sigroot/MCDProject/readme.md

This project is to design a MC68K based microcomputer on a single board.

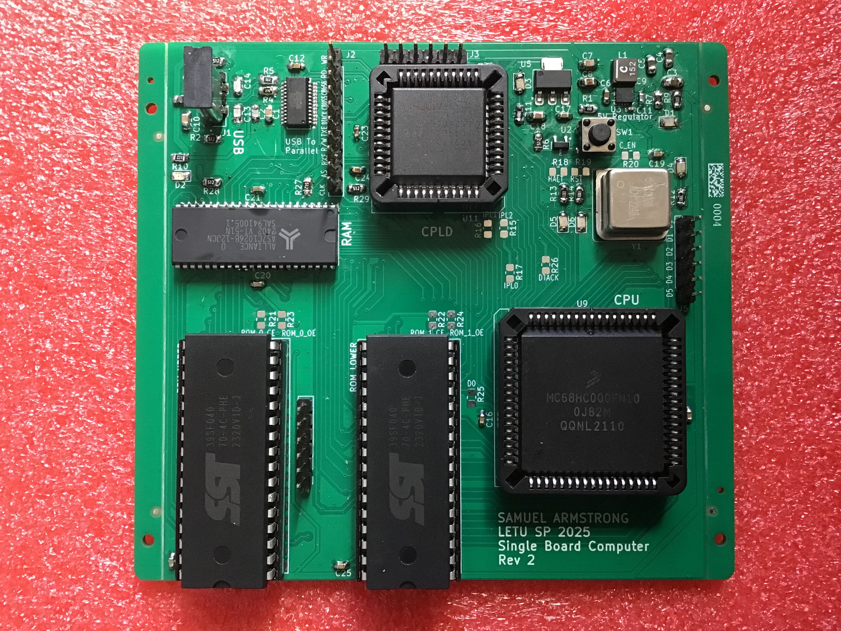
[picture p1: Images/CompletedBoard.jpg]
Board Photo
