sigroot/MCDProject/Metadata.ods

Sheet: TimeManagement
Date | Activity | Time Slot | Total Minutes | Total Hours |  |  |  | Lab Day
1-13 | Reading Docs | 3:33 – 5:26 | 113 | 1.88333333333333 |  |  |  | 02/19/25 | Listened to Dr. Kim Lecture, left early
1-14 | Reading Parts | 6:30 - 8:30 | 120 | 2 |  |  |  | 02/21/25 | Looked into interrupt
1-15 | Organizing Resouces | 2:36 – 2:44 | 8 | 0.133333333333333 |  |  |  |  |  | 1 | 2 | 3 | 4 | 5 | 6 | 7 | 8 | 8 | 9 | 10 | 11 | 12 | 13 | 14 | 15
1-15 | Reading Parts | 2:45 – 3:05 | 20 | 0.333333333333333 |  |  |  |  |  | 23.0833333333333 | 18.0666666666667 | 14.2666666666667 | 16.15 | 19.3666666666667 | 4.58333333333333 | 7.08333333333333 | 19.7083333333333 | 19.7083333333333 | 12.6666666666667 | 9.5 | 12 | 13.7666666666667 | 9.25
1-15 | Reading Parts | 7:23 – 8:52 | 89 | 1.48333333333333 |  |  |  |  |  |  |  |  |  |  |  |  |  |  |  |  |  |  |  |  | 14.2285714285714 | 213.428571428571
1-16 | Diagramming, Reading Textbook, Reading Parts, Research | 2:36 - 3:43 | 67 | 1.11666666666667
1-16 | Research, Part Selection, Reading | 4:05 - 5:00 | 55 | 0.916666666666667
1-16 | Reading Textbok, Reading Parts, PLCC Research | 5:30 - 6:59 | 89 | 1.48333333333333
1-18 | Bibliography | 9:45 - 9:58 | 13 | 0.216666666666667
1-18 | Spread-sheeting, Part search | 12:11 – 2:44 | 153 | 2.55
1-20 | Part Search, Spreadsheeting, Reading | 1:13 –5:05 | 232 | 3.86666666666667
1-20 | Part Search | 6:20 – 7:20 | 60 | 1
1-21 | Part Search, Schematic | 9:07 – 11:40 | 153 | 2.55
1-21 | Price Calculation, Schematics | 6:10 – 8:13 | 123 | 2.05 | Week 1
1-21 | Block Diagram | 8:14 – 9:45 | 90 | 1.5 | 23.0833333333333
1-22 | Weekly Report | 2:12 – 2:40 | 38* | 0
1-22 | Weekly Report | 3:05 – 4:15 | 70* | 0
1-22 | Part Search, Phil’s Lab tutorials | 5:45 – 8:23 | 158 | 2.63333333333333
1-23 | Found Buck-Boost Regulator | 8:03 – 9:03 | 60 | 1
1-23 | Part Search, Schematic Rewriting | 10:31 – 11:24 | 53 | 0.883333333333333
1-23 | Schematic Writing | 3:33 – 5:44 | 131 | 2.18333333333333
1-25 | USB-C Connection Reading | 10:31 – 12:15 | 104 | 1.73333333333333
1-25 | USB Wiring | 2:55 – 4:06 | 71 | 1.18333333333333
1-25 – 1-26 | Schematic Writing | 8:20 – 12:59 | 279 | 4.65
1-27 | Researching USB to Parallel, Schematic-ing | Many | 120 | 2 | Week 2
1-28 | Schematic Editing | 7:00 – 7:30 | 30 | 0.5 | 18.0666666666667
1-28 | Program Flowchart | 9:30 – 10:48 | 78 | 1.3
1-29 | Complete Schematic | 2:56 -… 3:45 | 49 | 0.816666666666667 |  | Time spent in January
1-30 | Collecting Footprints | 5:06-6:16 | 80 | 1.33333333333333 |  | 43.3
2-2 | Fixing Footprints | 4:30 – 5:06 | 36 | 0.6
2-2 | Finishing Schematic Again | 5:27 - 8:38 | 191 | 3.18333333333333
2-3 | Starting PCB, fixing footprints, setting design rules | 7:45-8:00, 11:45-12:05 | 35 | 0.583333333333333
2-3 | Working on PCB/Footprints | 3:29-5:33 | 124 | 2.06666666666667
2-4 | PCB Editing | 11:00-12:50 | 110 | 1.83333333333333
2-4 | PCB Editing, Adding sockets to BOM | 6:00 – 7:45 | 105 | 1.75
2-5 | Parts Ordering, Adding sockets to BOM | 7:50 – 8:20 | 30 | 0.5
2-5 | Parts Ordering | 10:40 – 11:33 | 53 | 0.883333333333333 | Week 3
2-5 | Parts Verifying, PCB work | 11:35 – 12:18 | 43 | 0.716666666666667 | 14.2666666666667
2-5 | Checking for parts on JLCPCB | 2:35 – 2:55 | 20 | 0.333333333333333
2-5 | Editing PCB | 6:45 – 9:20 | 145 | 2.41666666666667
2-6 | Editing PCB | 11:00 – 1:06 | 126 | 2.1
2-6 | Editing PCB | 4:04 – 5:45 | 101 | 1.68333333333333
2-8 | Editing PCB | 8:17 – 10:18 | 121 | 2.01666666666667
2-9 | Editing PCB | 12:15 – 5:51 | 336 | 5.6
2-10 | Conducting Schematic Fixes | 4:05 – 5:05 | 60 | 1 | Week 4
2-11 | Conducting Schematic Fixes | 12:00 – 1:00 | 60 | 1 | 16.15
2-12 | Finalizing Schematic Fixes | 3:30 - 3:45 | 15 | 0.25
2-12 | Fixing Fixes | 6:20 – 6:55 | 35 | 0.583333333333333
2-12, 2-13 | Editing PCB | 7:01 – 2:13 | 432 | 7.2
2-13 | Editing PCB | 12:25-1:15 | 50 | 0.833333333333333
2-14 | Editing PCB, Ordering Parts | 10:45 – 12:20 | 95 | 1.58333333333333
2-15 | Editing PCB | 2:30 – 5:30 | 180 | 3
2-16 | Finalizing PCB | 1:00 – 2:22 | 82 | 1.36666666666667
2-16 | PCB Editing | 2:39 – 3:03 | 24 | 0.4
2-16 | PCB Editing | 3:30 – 5:44 | 134 | 2.23333333333333
2-16 | PCB Ordering | 6:12 – 7:37 | 85 | 1.41666666666667 | Week 5 | 90.4333333333333
2-18 | Starting VHDL Project | 12:48 – 1:18 | 30 | 0.5 | 19.3666666666667
2-20 | Writing VHDL | 2:45 – 5:00 | 145 | 2.41666666666667
2-25 | Researching Interrupt programming | 12:55 – 1:22 | 27 | 0.45 | Week 6
2-25 | Writing VHDL | 6:07 – 7:50 | 103 | 1.71666666666667 | 4.58333333333333
2-27 | Starting Soldering | 3:00 – 6:00 | 180 | 3 |  | Time spent in February
2-28 | Completing Soldering (minus switch) | 2:00 – 5:00 | 180 | 3 |  | 58.2166666666667
3-1 | Added switch and socketed chips to board | 1:15 – 1:50 | 35 | 0.583333333333333 | Week 7
3-3 | Correcting VHDL | 11:20 – 11:50 | 30 | 0.5 | 7.08333333333333
3-5 | Finishing? VHDL, Installing FTDI Chip Drivers | 2:00 – 3:15 | 75 | 1.25
3-6 | Attempting to connect via FTDI drivers | 10:55 – 12:35 | 100 | 1.66666666666667
3-6 | Trying to figure out why the board cannot be seen (Found 3V3OUT only produces 1.4V) | 2:50 – 4:40 | 110 | 1.83333333333333
3-10 | Failed to desolder the FTDI chip, destroyed pads, need to resolder | 1:10 – 7:50 | 400 | 6.66666666666667 |  | 10.1666666666667
3-11 | Successfully desoldered USB connector | 1:05 – 1:40 | 35 | 0.583333333333333
3-11 | Desoldered old board, soldered new board | 2:00 – 11:00 | 540 | 9 | Week 7.5
3-12 | Attempted to see board from PC | 5:30 – 7:10 | 100 | 1.66666666666667 | 22.6666666666667
3-13 | Managed to see FTDI (Resistor on D+ was bad, Reset was being pulled to ground by unprogrammed CPLD) | 3:05 – 3:28 | 23 | 0.383333333333333
3-13 | Testing board, learning makefiles | 3:30 – 4:05 | 35 | 0.583333333333333
3-14 | Learnking makefiles | 12:00 – 12:27 | 27 | 0.45
3-14 | Writing VHDL to CPLD | 1:30 – 1:45 | 75 | 1.25
3-14 | Attempting to program ROM (Can’t detect programmer on linux) | 3:00 – 4:25 | 85 | 1.41666666666667
3-15 | Getting Pi4 ready | 11:00 – 12:00 | 60 | 1
3-15 | Making ROM Programmer | 2:00 – 6:30 | 270 | 4.5
3-17 | Connecting to programmer | 4:00 – 5:20 | 80 | 1.33333333333333
3-18 | Attempting to program ROM (Could program, wrong result) | 12:00 – 1:20 | 80 | 1.33333333333333
3-18 | Troubleshooting Board | 4:30 – 7:00 | 150 | 2.5
3-18 | Realizing error in VHDL | 8:45 – 9:00 | 15 | 0.25 | Week 8 | Weeks 7.5 + 8
3-19 | Successfully ran code | 10:25 – 12:10 | 105 | 1.75 | 16.75 | 39.4166666666667
3-19 | Attempting to receive “Hello, World!” (Garbled) | 7:05 – 9:00 | 115 | 1.91666666666667
3-20 | Got “Hello, World!”, working on interrupts | 2:30 – 5:45 | 195 | 3.25
3-22 | Attempted to probe for RAM issues | 4:00 – 4:55 | 55 | 0.916666666666667
3-22 | Confirmed RAM is functional, Wrote program, Determined possible VHDL write communication issue. | 6:10 – 9:00 | 170 | 2.83333333333333
3-24 | Attempting echo sent text | 2:10 – 4:00 | 110 | 1.83333333333333
3-26 | Probing communication | 1:30 – 2:30 | 60 | 1 | Week 9
3-26 | Debugging communication code | 7:30 – 8:25 | 55 | 0.916666666666667 | 12.6666666666667
3-28 | Debugging with Lucas (oscilloscope) | 10:30 – 12:40 | 130 | 2.16666666666667
3-29 | Debugging communication code | 4:15 – 5:45 | 90 | 1.5
3-29 | Checking results of debugging (noticed read bytes match opcode values) | 6:30 – 6:45 | 15 | 0.25 |  | Time spent in March
3-30 | Fixing UTP reads | 12:45 – 350 | 185 | 3.08333333333333 | Week 10 | 60.1666666666667
4-1, 2 | Making Linker Script | 11:30 – 2:00 | 150 | 2.5 | 9.5
4-2 | Attempting to use C code | 6:00 – 7:00 | 60 | 1
4-3 | Realized trying to write to linker symbols causes crash, writes are done manually now | 2:30 – 6:50 | 260 | 4.33333333333333
4-6 | Working on Code | 2:00 – 4:00 | 120 | 2
4-6 | Got linker to work with includes | 5:15 – 6:15 | 60 | 1
4-7 | Testing the pins for errors | 11:45-12:15 | 30 | 0.5
4-8 | Reprogramming main | 10:45 – 1:00 | 145 | 2.41666666666667 | Week 11
4-9 | Working on Monitor | 11:45 – 12-30 | 45 | 0.75 | 12
4-10 | Got monitor main menu working | 2:30 – 5:24 | 176 | 2.93333333333333
4-11 | Got parsing | 10:30 – 12:45 | 135 | 2.25
4-12 | Working on monitor | 3:15 – 4:15 | 60 | 1
4-13 | Working on monitor | 2:00 – 4:15 | 135 | 2.25 | Week 12
4-13 | Finish V1 on monitor | 6:30 – 11:50 | 320 | 5.33333333333333 | 13.7666666666667
4-14 | Testing monitor. | 8:50 – 9:30 | 40 | 0.666666666666667
4-14 | Made tweaks to monitor. Works properly. Worked on S-Record | 10:35 – 12:35 | 120 | 2 |  |  | 85.7166666666667
4-20 | Commenting Monitor | 1:35 – 2:10 | 35 | 0.583333333333333 |  | Time spent in April
4-20,4-21 | Writing S-Record Program (Fireplace) | 8:00 – 2:00 | 360 | 6 | Week13 | 37.5166666666667
 |  |  | 11952 | 199.2 | 9.25

Sheet: Sources
Links | Notes
https://www.youtube.com/watch?v=0LSG5uIdqJc
resources.altium.com
https://www.microwaves101.com/encyclopedias/even-and-odd-mode-impedances
https://blog.clevercompliance.io/electrical-product-compliance/what-is-emc-testing/
https://www.pcbasic.com/blog/power_supply_pcb.html
https://ww1.microchip.com/downloads/aemDocuments/documents/VOP/ApplicationNotes/ApplicationNotes/Signal+Types+and+Terminations.pdf
https://www.reddit.com/r/AskElectronics/comments/15q1bvo/how_well_regulated_is_usb_will_the_supply_voltage/
https://www.ti.com/lit/an/slyt118/slyt118.pdf
https://stackoverflow.com/questions/12678698/emulating-uart-over-usb
https://www.circuitbread.com/tutorials/communicating-with-a-pc-using-uart---part-11-microcontroller-basics-pic10f200
https://www.nextpcb.com/blog/spi-i2c-uart
https://electronics.stackexchange.com/questions/110478/difference-between-uart-and-rs-232
https://madpcb.com/glossary/
https://resources.altium.com/p/copper-pour-and-stitching-do-you-need-them-pcb-layout
https://www.altium.com/documentation/altium-designer/via-stitching-via-shielding-pcb
https://www.analog.com/en/resources/technical-articles/successful-pcb-grounding-with-mixedsignal-chips--follow-the-path-of-least-impedance.htmlhttps://www.eur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
https://ecsxtal.com/store/pdf/output-signal-types.pdf
https://superuser.com/questions/317217/whats-the-maximum-typical-speed-possible-with-a-usb2-0-drive
https://www.raypcb.com/soic-vs-ssop/
https://reversepcb.com/the-basics-of-quad-flat-no-leads-qfn-packaging/
https://www.howtogeek.com/53587/usb-explained-all-the-different-types-and-what-theyre-used-for/
https://resources.altium.com/p/isolated-vs-non-isolated-power-supplies-right-choice-without-fail
https://www.ablic.com/en/semicon/products/power-management-ic/switching-regulator/intro-2/
https://digilent.com/reference/_media/jtag-usb_full_speed/jtag-usb_fs_rm.pdf
https://electronics.stackexchange.com/questions/566073/why-usb-c-has-4-vbus-and-how-does-it-affect-my-design
https://electronics.stackexchange.com/questions/4515/how-to-connect-usb-connector-shield
https://www.allaboutcircuits.com/technical-articles/introduction-to-usb-type-c-which-pins-power-delivery-data-transfer/
https://www.analogictips.com/what-is-pssr-and-why-is-it-important-in-op-amps-and-ldos-faq/
https://store.curiousinventor.com/guides/Surface_Mount_Soldering/QFN
https://www.youtube.com/@PhilsLab/search?query=USB-C
https://electronics.stackexchange.com/questions/327791/using-usb-c-as-a-power-source
https://www.ti.com/lit/an/snva559c/snva559c.pdf
https://forum.kicad.info/t/how-to-do-dip-sockets-and-the-dip-parts/51956/4
https://github.com/KiCad | For footprints
https://www.baldengineer.com/kicad-bus-labels-and-global-labels.html
https://www.ti.com/lit/sg/sdyu001ab/sdyu001ab.pdf?ts=1737822780380 | VIH is Voltage of an input for high value. MCU is 2V min
https://www.digikey.com/en/maker/projects/how-to-route-differential-pairs-in-kicad-for-usb/45b99011f5d34879ae1831dce1f13e93
https://www.ti.com/lit/wp/slyy109b/slyy109b.pdf?ts=1682067298687
https://developerhelp.microchip.com/xwiki/bin/view/applications/usb/typec-features/cc-vconn-signals/
https://ww1.microchip.com/downloads/en/AppNotes/00001953A.pdf | USB-C Datasheet
https://makbit.com/forum/viewtopic.php?t=21
https://www.edn.com/add-a-manual-reset-to-a-standard-three-pin-reset-supervisor/
https://hackaday.com/2014/03/05/hackaday-68k-blinking-a-led/ | Descriptions of extra pins and how to ignore them
https://electronics.stackexchange.com/questions/389972/usb-shield-to-ground-or-not-to-ground
https://docs.kicad.org/master/en/eeschema/eeschema_schematic_creation_and_editing.html
https://www.ecstaticlyrics.com/electronics/USB/FT240X/
https://resources.altium.com/p/how-do-ferrite-beads-work-and-how-do-you-choose-right-one
https://www.pcbasic.com/blog/circuit_board_capacitor.html
https://www.macrofab.com/blog/bypass-caps-decouple-your-way-to-cleaner-power/
https://regextutorial.org/regex-for-numbers-and-ranges.php | For auto netclass assignment
http://dangerousprototypes.com/blog/2011/11/05/app-note-cpld-special-function-pins/
https://makbit.com/forum/viewtopic.php?t=21
https://forum.kicad.info/t/difference-between-f-fab-and-f-silks/16994
https://www.youtube.com/watch?v=uQkCe9-b9FI | How to use a desolder gun
https://electronics.stackexchange.com/questions/86961/how-to-assign-physical-pins-of-fpga-to-xilinx-ise-verilog-modules
https://electronics.stackexchange.com/questions/86961/how-to-assign-physical-pins-of-fpga-to-xilinx-ise-verilog-modules
https://adaptivesupport.amd.com/s/question/0D52E00006hpaGgSAI/connecting-io-pins-in-chipscope?language=en_US
https://hackaday.com/2008/12/11/how-to-programmable-logic-devices-cpld/
https://www.etechnophiles.com/raspberry-pi-4-gpio-pinout-specifications-and-schematic/ | Note: RP4 GPIO CANNOT take 5V input
https://sourceware.org/binutils/docs/ld | How to use linker scripts
https://wiki.osdev.org | How to do baremetal commands
https://softwareengineering.stackexchange.com/questions/194339/frame-pointer-explanation
https://stackoverflow.com/questions/7943628/where-will-a-constant-string-be-stored-in-memory | A comment mentioned .rodata
https://www.geeksforgeeks.org/length-of-array-in-c/
https://mcuoneclipse.com/2013/04/14/text-data-and-bss-code-and-data-size-explained/
https://hackaday.com/2018/05/02/directly-executing-chunks-of-memory-function-pointers-in-c/
https://gist.github.com/ConnerWill/d4b6c776b509add763e17f9f113fd25b

Sheet: Parts
Nickname | Part Name | Datasheet | Digikey Link | Price | Voltage Req. (V) | Current Used (mA) | Given? | Quantity | Notes | Used
MPU | MC68HC000FN10 | https://www.nxp.com/docs/en/reference-manual/MC68000UM.pdf | N/A | 0 | 5 | 30 | TRUE | 1 | 10MHz, 68-PLCC | x
MPU-Socket | 8468-11B1-RK-TP | https://www.digikey.com/en/products/detail/3m/8468-11B1-RK-TP/1026475 | https://www.digikey.com/en/products/detail/3m/8468-11B1-RK-TP/1026475 | 2.79 | N/A | N/A | FALSE | 1 | 68-pin,There are also PLCC | x
CPLD | XC9572XL-10PC44I | https://docs.amd.com/v/u/en-US/ds057 | https://www.digikey.com/en/products/detail/amd/XC9572XL-10PC44I/406978 | 0 | 3.3 | 30-60 | TRUE | 1 | Given, 10MHZ, 44-PLCC, 34 User I/O | x
CPLD Socket | 8444-11B1-RK-TP | https://www.digikey.com/en/products/detail/3m/8444-11B1-RK-TP/1026473 | https://multimedia.3m.com/mws/media/358813O/3m-chip-carrier-sockets-lp-4-row-t-h-8400-series-ts2148.pdf | 2.14 | N/A | N/A | FALSE | 1 | 44-pin, There are also PLCC | x
JTAG Header | ADT-AMP1251106S4BS165A1 | https://app.adam-tech.com/products/download/data_sheet/192971/adt-amp1251106s4bs165a1-data-sheet.pdf | https://www.digikey.com/en/products/detail/adam-tech/ADT-AMP1251106S4BS165A1/9832042 | 0.85 | N/A | N/A | FALSE | 1 | 1x6 Header 2.54 pitch | x
Oscillator | ACH-8.000MHZ-EK | https://abracon.com/Oscillators/ACH.pdf | https://www.digikey.com/en/products/detail/abracon-llc/ACH-8-000MHZ-EK/675379 | 2.66 | 5 | 30 | FALSE | 1 | 5V, slightly lower than chips’ max clock | x
0.5 MB Flash ROM | SST39SF040-70-4C-NHE | https://ww1.microchip.com/downloads/aemDocuments/documents/MPD/ProductDocuments/DataSheets/SST39SF010A-SST39SF020A-SST39SF040-Data-Sheet-DS20005022.pdf | https://www.digikey.com/en/products/detail/microchip-technology/SST39SF040-70-4C-NHE/2297834 | 2.76 | 5 | 10 | FALSE | 2 |  | x
64k x 16 bit (1MB) SRAM | AS7C1026B-12JCN | https://www.alliancememory.com/wp-content/uploads/pdf/sram/fa/as7c1026bv1.3.pdf | https://www.digikey.com/en/products/detail/alliance-memory-inc/AS7C1026B-12JCN/4234605 | 3.83 | 5 | 100 | FALSE | 1 | Low power when not read or written from | x
Button | PTS647 | https://www.ckswitches.com/media/2567/pts647.pdf | https://www.digikey.com/en/products/detail/c-k/Y97KT23B0FAFP/21395848 | 0 | N/A | N/A | TRUE | 1 | For Reset | x
USB Port | UJ20-C-V-C-3-SMT-TR | https://www.sameskydevices.com/product/resource/uj20-c-v-c-3-smt-tr.pdf | https://www.digikey.com/en/products/detail/same-sky-formerly-cui-devices/UJ20-C-V-C-3-SMT-TR/24766913 | 0.89 | N/A | N/A | FALSE | 1 | USB 2.0 | x
USB to Parallel | FT240XS-R | https://www.ftdichip.com/Support/Documents/DataSheets/ICs/DS_FT240X.pdf | https://www.digikey.com/en/products/detail/ftdi-future-technology-devices-international-ltd/FT240XS-R/3029137 | 2.38 | 5V | 8 | FALSE | 1 | 3.3V Out supply max 50mA, 12MHz clock | x
Supervisor Chip 5V | MIC2774N-46YM5-TR | https://ww1.microchip.com/downloads/en/DeviceDoc/mic2774.pdf | https://www.digikey.com/en/products/detail/microchip-technology/MIC2774L-46YM5-TR/1616833 | 0.95 | 5V | 0.0035 | FALSE | 1 | Open Drain Reset Output | x
Supervisor Chip 3.3V | MIC2774N-31YM5-TR | https://ww1.microchip.com/downloads/en/DeviceDoc/mic2774.pdf | https://www.digikey.com/en/products/detail/microchip-technology/MIC2774N-31YM5-TR/771571 | 0.95 | 3.3V | 0.0035 | FALSE | 1 | Open Drain Reset Output | x
5V Regulator | L4995JTR | https://www.st.com/content/ccc/resource/technical/document/datasheet/2e/38/3f/f5/39/70/41/0d/CD00149577.pdf/files/CD00149577.pdf/jcr:content/translations/en.C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 | https://www.digikey.com/en/products/detail/stmicroelectronics/L4995JTR/2035007 | 2.14 | 5.6V | N/A | FALSE | 1 | NOTE: LOW PDRR, Reset w/ Delay, Watchdog, Thermal shutdown | x
3.3V Regulator | LD1117S33TR | https://www.st.com/content/ccc/resource/technical/document/datasheet/99/3b/7d/91/91/51/4b/be/CD00000544.pdf/files/CD00000544.pdf/jcr:content/translations/en.C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 | https://www.digikey.com/en/products/detail/stmicroelectronics/LD1117S33TR/585766 | 0.34 | 4.5V | N/A | FALSE | 1 | Needs 10uF Cap | x
Barrel Wall Adapter | 1471 | https://www.pololu.com/product-info-merged/1471 | https://www.digikey.com/en/products/detail/pololu/1471/19200224 | 8.19 | N/A | N/A | FALSE | 1 | 12V, 1A output | x
Cheaper Wall Adapter | WR9HD1333CCP-F(R6B) | https://spec.globtek.info/spec/?id=01t0c000008PBx0 | https://www.digikey.com/en/products/detail/globtek-inc/WR9HD1333CCP-F-R6B/13245472 | 3.94 | N/A | N/A | FALSE | 1 | 9V, 1.3A Output | x
Barrel Connector | ADC-002-1 | https://www.digikey.com/en/products/detail/adam-tech/ADC-002-1/21710741 | https://app.adam-tech.com/products/download/data_sheet/203725/adc-002-x-data-sheet.pdf | 0.39 | N/A | N/A | FALSE | 1 | Max 20V, 4A? Or 12V, 1A, Mate: 2.05mm – 5.5mm | x
 |  |  |  | 35.2
Rainy Day Parts
5V Regulator | LD1117S50TR | https://www.st.com/content/ccc/resource/technical/document/datasheet/99/3b/7d/91/91/51/4b/be/CD00000544.pdf/files/CD00000544.pdf/jcr:content/translations/en.C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 | https://www.digikey.com/en/products/detail/stmicroelectronics/LD1117S50TR/1038360 | 0.35 | 6.2V | N/A | FALSE | 1 | Needs 10uF Cap
To Add
Capacitors
Resistors
LEDs
PCB
JLCPCB | Standard PCB | https://jlcpcb.com/help/catalog/11-PCB-or-Stencil-Ordering | https://cart.jlcpcb.com/quote?orderType=1&stencilLayer=2&stencilWidth=100&stencilLength=100 | ~$8 + $17.50 Shipping |  |  | FALSE | 5 min | Check manual/Faq
Final Version
MPU | MC68HC000FN10 | https://www.nxp.com/docs/en/reference-manual/MC68000UM.pdf | N/A | 0 | 5 | 30 | TRUE | 1 | 10MHz, 68-PLCC | x
MPU-Socket | 8468-11B1-RK-TP | https://www.digikey.com/en/products/detail/3m/8468-11B1-RK-TP/1026475 | https://www.digikey.com/en/products/detail/3m/8468-11B1-RK-TP/1026475 | 2.79 | N/A | N/A | FALSE | 1 | 68-pin,There are also PLCC | x
CPLD | XC9572XL-10PC44I | https://docs.amd.com/v/u/en-US/ds057 | https://www.digikey.com/en/products/detail/amd/XC9572XL-10PC44I/406978 | 0 | 3.3 | 30-60 | TRUE | 1 | Given, 10MHZ, 44-PLCC, 34 User I/O | x
CPLD Socket | 8444-11B1-RK-TP | https://www.digikey.com/en/products/detail/3m/8444-11B1-RK-TP/1026473 | https://multimedia.3m.com/mws/media/358813O/3m-chip-carrier-sockets-lp-4-row-t-h-8400-series-ts2148.pdf | 2.14 | N/A | N/A | FALSE | 1 | 44-pin, There are also PLCC | x
JTAG Header | ADT-AMP1251106S4BS165A1 | https://app.adam-tech.com/products/download/data_sheet/192971/adt-amp1251106s4bs165a1-data-sheet.pdf | https://www.digikey.com/en/products/detail/adam-tech/ADT-AMP1251106S4BS165A1/9832042 | 0.85 | N/A | N/A | FALSE | 1 | 1x6 Header 2.54 pitch | x
Oscillator | ACH-8.000MHZ-EK | https://abracon.com/Oscillators/ACH.pdf | https://www.digikey.com/en/products/detail/abracon-llc/ACH-8-000MHZ-EK/675379 | 2.66 | 5 | 30 | FALSE | 1 | 5V, slightly lower than chips’ max clock | x
0.5 MB Flash ROM | SST39SF040-70-4C-NHE | https://ww1.microchip.com/downloads/aemDocuments/documents/MPD/ProductDocuments/DataSheets/SST39SF010A-SST39SF020A-SST39SF040-Data-Sheet-DS20005022.pdf | https://www.digikey.com/en/products/detail/microchip-technology/SST39SF040-70-4C-NHE/2297834 | 2.76 | 5 | 10 | FALSE | 2 |  | x
Rom Socket | 8432-11B1-RK-TP | https://multimedia.3m.com/mws/media/358813O/3m-chip-carrier-sockets-lp-4-row-t-h-8400-series-ts2148.pdf | https://www.digikey.com/en/products/detail/3m/8432-11B1-RK-TP/1026472 | 1.89 | N/A | N/A | FALSE | 2 |  | x
64k x 16 bit (1MB) SRAM | AS7C1026B-12JCN | https://www.alliancememory.com/wp-content/uploads/pdf/sram/fa/as7c1026bv1.3.pdf | https://www.digikey.com/en/products/detail/alliance-memory-inc/AS7C1026B-12JCN/4234605 | 3.83 | 5 | 100 | FALSE | 1 | Low power when not read or written from | x
Button | PTS647 | https://www.ckswitches.com/media/2567/pts647.pdf | https://www.digikey.com/en/products/detail/c-k/Y97KT23B0FAFP/21395848 | 0 | N/A | N/A | TRUE | 1 | For Reset | x
USB Port | UJ20-C-V-C-3-SMT-TR | https://www.sameskydevices.com/product/resource/uj20-c-v-c-3-smt-tr.pdf | https://www.digikey.com/en/products/detail/same-sky-formerly-cui-devices/UJ20-C-V-C-3-SMT-TR/24766913 | 0.89 | N/A | N/A | FALSE | 1 | USB 2.0 | x
USB to Parallel | FT240XS-R | https://www.ftdichip.com/Support/Documents/DataSheets/ICs/DS_FT240X.pdf | https://www.digikey.com/en/products/detail/ftdi-future-technology-devices-international-ltd/FT240XS-R/3029137 | 2.38 | 5 | 8 | FALSE | 1 | 3.3V Out supply max 50mA, 12MHz clock | x
5V Regulator | ISL9110IRT7Z-T7A | https://www.renesas.com/en/document/dst/isl9110-isl9112-japanese-datasheet?r=529186 | https://www.digikey.com/en/products/detail/renesas-electronics-corporation/ISL9110IRT7Z-T7A/2709422 | 3.1 | 5 | N/A | FALSE | 1 | Thermal pad = PGND should have isolated thermal pad; 2 10uF Cap | x
3.3V Regulator | LD1117S33TR | https://www.st.com/content/ccc/resource/technical/document/datasheet/99/3b/7d/91/91/51/4b/be/CD00000544.pdf/files/CD00000544.pdf/jcr:content/translations/en.C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 | https://www.digikey.com/en/products/detail/stmicroelectronics/LD1117S33TR/585766 | 0.34 | 4.5V | N/A | FALSE | 1 | Needs 10uF Cap | x
Inductor | 744025002 | https://www.we-online.com/components/products/datasheet/744025002.pdf | https://www.digikey.com/en/products/detail/w%C3%BCrth-elektronik/744025002/2445620 | 1.48 | N/A | ~0 | FALSE | 1
Ferrite Bead | PE-0805PFB221ST | https://productfinder.pulseelectronics.com/api/open/part-attachments/datasheet/PE-0805PFB221ST | https://www.digikey.com/en/products/detail/pulse-electronics/PE-0805PFB221ST/5050550 | 0.1 | N/A | N/A | FALSE | 1
27 Ohm Resistor | ERJ-P06J270V | https://industrial.panasonic.com/cdbs/www-data/pdf/RDO0000/AOA0000C331.pdf | https://www.digikey.com/en/products/detail/panasonic-electronic-components/ERJ-P06J270V/525246 | 0.12 | N/A | N/A | FALSE | 2
5.1k Ohm Resistor | RC0805JR-075K1L | https://www.yageo.com/upload/media/product/products/datasheet/rchip/PYu-RC_Group_51_RoHS_L_12.pdf | https://www.digikey.com/en/products/detail/yageo/RC0805JR-075K1L/728338 | 0.1 | N/A | N/A | FALSE | 27
220 Ohm Resistor | AC0805JR-07220RL | https://www.yageo.com/upload/media/product/productsearch/datasheet/rchip/PYu-AC_51_RoHS_L_10.pdf | https://www.digikey.com/en/products/detail/yageo/AC0805JR-07220RL/5897094 | 0.1 | N/A | N/A | FALSE | 6
1 x 6 JTAG Header | ADT-AMP1251106S4BS165A1 | https://app.adam-tech.com/products/download/data_sheet/192971/adt-amp1251106s4bs165a1-data-sheet.pdf | https://www.digikey.com/en/products/detail/adam-tech/ADT-AMP1251106S4BS165A1/9832042 | 0.85 | N/A | N/A | FALSE | 3
10 uF Capacitor |  |  |  |  |  |  |  | 3
100nF Capacitor |  |  |  |  |  |  |  | 1
 |  |  |  | 35.95
Kicad List
 | Reference | Value | Datasheet | Footprint | Qty | DNP | Unit Price
x | C1,C12,C15,C16,C17,C19,C20,C21,C22,C23,C24,C25,C26 | 100nF | https://www.digikey.com/en/products/detail/samsung-electro-mechanics/CL10E104KC8VPNC/20498486 | Capacitor_SMD:C_0603_1608Metric_Pad1.08x0.95mm_HandSolder | 13 |  | 0.27
x | C2 | 4.7uF | https://www.digikey.com/en/products/detail/cal-chip-electronics-inc/GMC10X7R475K10NT/24343641 | Capacitor_SMD:C_0603_1608Metric_Pad1.08x0.95mm_HandSolder | 1 |  | 0.28
x | C3,C4,C5 | 22uF | https://www.digikey.com/en/products/detail/samsung-electro-mechanics/CL21A226KQCLRNC/5961171 | Capacitor_SMD:C_0805_2012Metric_Pad1.18x1.45mm_HandSolder | 3 |  | 0.11
x | C6,C9 | 10uF | https://www.digikey.com/en/products/detail/samsung-electro-mechanics/CL10A106KQ8NNNC/3886696 | Capacitor_SMD:C_0603_1608Metric_Pad1.08x0.95mm_HandSolder | 2 |  | 0.08
x | C7,C8,C10,C18 | 10uF | https://www.digikey.com/en/products/detail/samsung-electro-mechanics/CL21A106KOQNNNG/3894417 | Capacitor_SMD:C_0805_2012Metric_Pad1.18x1.45mm_HandSolder | 4 |  | 0.08
x | C11 | 100nF | https://www.digikey.com/en/products/detail/samsung-electro-mechanics/CL05B104KP5VPNC/20498482 | Capacitor_SMD:C_0402_1005Metric_Pad0.74x0.62mm_HandSolder | 1 |  | 0.1
x | C13,C14 | 47pF | https://www.digikey.com/en/products/detail/cal-chip-electronics-inc/CHV0805N250470FCT/22155337 | Capacitor_SMD:C_0805_2012Metric_Pad1.18x1.45mm_HandSolder | 2 |  | 0.46
x | D1,D2,D3,D4,D5,D6 | LED | https://www.digikey.com/en/products/detail/harvatek-corporation/B1701USD-20D000114U1930/16671746 | LED_SMD:LED_0805_2012Metric_Pad1.15x1.40mm_HandSolder | 6 |  | 0.1
x | FB1 | MI0805K601R-10 | https://www.digikey.com/en/products/detail/laird-signal-integrity-products/MI0805K601R-10/806628 | Inductor_SMD:L_0805_2012Metric_Pad1.15x1.40mm_HandSolder | 1 |  | 0.22
x | J1 | USB_C_Receptacle_USB2.0_16P | https://www.digikey.com/en/products/detail/same-sky-formerly-cui-devices/UJ20-C-V-C-3-SMT-TR/24766913 | CustomComponents:CUI_UJ20-C-V-C-3-SMT-TR | 1 |  | 0.89
x | J2 | Conn_01x10_Pin | https://www.digikey.com/en/products/detail/amphenol-cs-fci/10129378-910002BLF/7915958 | Connector_PinHeader_2.54mm:PinHeader_1x10_P2.54mm_Vertical | 1 |  | 0.18
x | J3,J4,J5 | Conn_01x06_Pin | https://www.digikey.com/en/products/detail/amphenol-cs-commercial-products/G800W302018EU/17069165 | Connector_PinHeader_2.54mm:PinHeader_1x06_P2.54mm_Vertical | 3 |  | 0.11
x | L1 | 1.5u | https://www.digikey.com/en/products/detail/coilcraft/XFL4020-152MEC/21381168 | Inductor_SMD:L_Coilcraft_XxL4020 | 1 |  | 12.8
x | R1 | 10k | https://www.digikey.com/en/products/detail/panasonic-electronic-components/ERJ-6GEYJ103V/83062 | Resistor_SMD:R_0805_2012Metric_Pad1.20x1.40mm_HandSolder | 1 |  | 0.1
x | R2,R3,R6,R27,R28,R29 | 5.1k | https://www.digikey.com/en/products/detail/yageo/RC0805JR-075K1L/728338 | Resistor_SMD:R_0805_2012Metric_Pad1.20x1.40mm_HandSolder | 6 |  | 0.015
x | R4,R5 | 27 | https://www.digikey.com/en/products/detail/panasonic-electronic-components/ERJ-P06J270V/525246 | Resistor_SMD:R_0805_2012Metric_Pad1.20x1.40mm_HandSolder | 2 |  | 0.48
x | R7 | 100k | https://www.digikey.com/en/products/detail/koa-speer-electronics-inc/RN73H2ATTD1003F100/10090085 | Resistor_SMD:R_0805_2012Metric_Pad1.20x1.40mm_HandSolder | 1 |  | 0.15
x | R8 | 0 | https://www.digikey.com/en/products/detail/panasonic-electronic-components/ERJ-6GEY0R00V/78163 | Resistor_SMD:R_0805_2012Metric_Pad1.20x1.40mm_HandSolder | 1 |  | 0.1
x | R9,R10,R11,R12,R13,R14 | 1k | https://www.digikey.com/en/products/detail/yageo/RC0805FR-071KL/727444 | Resistor_SMD:R_0805_2012Metric_Pad1.20x1.40mm_HandSolder | 6 |  | 0.02
x | SW1 | SW_DPST_x2_Custom | https://www.ckswitches.com/media/2567/pts647.pdf | Button_Switch_SMD:SW_SPST_PTS647_Sx38 | 1 |  | 0
x | U1 | 8468-11B1-RK-TP | https://www.digikey.com/en/products/detail/3m/8468-11B1-RK-TP/1026475 | Package_LCC:PLCC-68_THT-Socket | 1 | DNP | 2.79
x | U2 | TLV809EA46DBZR | https://www.digikey.com/en/products/detail/texas-instruments/TLV809EA46DBZR/11308885 | Package_TO_SOT_SMD:SOT-23 | 1 |  | 0.26
x | U3 | TPS630701RNMT | https://www.digikey.com/en/products/detail/texas-instruments/TPS630701RNMT/6193742 | CustomComponents:RNM0015A | 1 |  | 3.12
x | U4 | FT240XS | https://www.digikey.com/en/products/detail/ftdi-future-technology-devices-international-ltd/FT240XS-R/3029137 | Package_SO:SSOP-24_3.9x8.7mm_P0.635mm | 1 |  | 2.38
x | U5 | LD1117S33TR_SOT223 | https://www.digikey.com/en/products/detail/stmicroelectronics/LD1117S33TR/585766 | Package_TO_SOT_SMD:SOT-223-3_TabPin2 | 1 |  | 0.34
x | U6 | 8444-11B1-RK-TP | https://www.digikey.com/en/products/detail/3m/8444-11B1-RK-TP/1026473 | TO_11B1-RK-TP_3MM | 1 | DNP | 2.14
x | U7,U8 | 4832-6000-CP | https://www.digikey.com/en/products/detail/3m/4832-6000-CP/1133623 | Package_DIP:DIP-32_W15.24mm_Socket | 2 | DNP | 0.99
x | U9 | MC68000FN | https://www.nxp.com/docs/en/reference-manual/MC68000UM.pdf | Package_LCC:PLCC-68_THT-Socket | 1 |  | 0
x | U10 | AS7C1026B-12JCN | https://www.digikey.com/en/products/detail/alliance-memory-inc/AS7C1026B-12JCN/4234605 | Package_SO:SOJ-44_10.16x28.575mm_P1.27mm | 1 |  | 3.48
x | U11 | XC9572XL-PC44 | https://docs.amd.com/v/u/en-US/ds057 | Package_LCC:PLCC-44_THT-Socket | 1 |  | 0
x | U12,U13 | SST39SF040-70-4C-PHE | https://www.digikey.com/en/products/detail/microchip-technology/SST39SF040-70-4C-PHE/2297835?0=%2Fmemory | Package_DIP:DIP-32_W15.24mm_Socket_LongPads | 2 |  | 3.99
x | Y1 | CXO_DIP8 | https://www.digikey.com/en/products/detail/abracon-llc/ACH-8-000MHZ-EK/675379 | Oscillator:Oscillator_DIP-8 | 1 |  | 3.68
 |  |  |  |  |  | 50.31
IC REG BUCK BOOST 5V 2A 15VQFN | 296-44765-1-ND | 2 | 3.12
USB AM TO USB C, USB 2.0 - 150MM | 2987-DH-20M50054-ND | 1 | 1.29
CAP0603 X7R 4.7UF 10% 10V | 4713-GMC10X7R475K10NTCT-ND | 3 | 0.28
CAP CER 100NF 100V X8L 0603 | 1276-CL10E104KC8VPNCCT-ND | 17 | 0.155
CAP CER 22UF 6.3V X5R 0805 | 1276-6687-1-ND | 5 | 0.11
CAP CER 10UF 6.3V X5R 0603 | 1276-1038-1-ND | 10 | 0.03
CAP CER 10UF 16V X5R 0805 | 1276-6455-1-ND | 10 | 0.015
: CAP CER 100NF 10V X7R 0402 | 1276-CL05B104KP5VPNCCT-ND | 3 | 0.1
HVCAP0805 COG 47PF 1% 250V | 4713-CHV0805N250470FCT-ND | 4 | 0.46
LED RED DIFFUSED 0805 SMD | 3147-B1701USD-20D000114U1930CT-ND | 10 | 0.091
FERRITE BEAD 600 OHM 0805 1LN | 240-2390-1-ND | 3 | 0.22
USB JACK 2.0, TYPE-C, VERTICAL | 2223-UJ20-C-V-C-3-SMT-TRCT-ND | 2 | 0.89
CONN HEADER VERT 10POS 2.54MM | 10129378-910002BLF-ND | 2 | 0.18
PIN HEADER 2.54MM PITCH STR DIP, | 664-G800W302018EU-ND | 6 | 0.11
RES 5.1K OHM 5% 1/8W 0805 | 311-5.1KARCT-ND | 10 | 0.008
RES SMD 10K OHM 5% 1/8W 0805 | P10KACT-ND | 3 | 0.1
RES SMD 27 OHM 5% 1/2W 0805 | P27ADCT-ND | 4 | 0.12
RES SMD 0 OHM JUMPER 1/8W 0805 | P0.0ACT-ND | 2 | 0.1
RES 100K OHM 1% 1/8W 0805 | 2019-RN73H2ATTD1003F100CT-ND | 3 | 0.15
RES 1K OHM 1% 1/8W 0805 | 311-1.00KCRCT-ND | 10 | 0.12
CONN SOCKET PLCC 68POS TIN | 3M6811B1-ND | 1 | 2.79
IC SUPERVISOR 1 CHANNEL SOT23-3 | 296-TLV809EA46DBZRCT-ND | 3 | 0.26
IC USB FS PARALLEL FIFO 24SSOP | 768-1127-1-ND | 2 | 2.38
IC REG LINEAR 3.3V 800MA SOT-223 | 497-1242-1-ND | 2 | 0.34
CONN SOCKET PLCC 44POS TIN | 3M4411B1-ND | 1 | 2.14
CONN IC DIP SOCKET 32POS TIN | 3M5470-ND | 4 | 0.99
IC SRAM 1MBIT PARALLEL 44SOJ | 1450-1046-ND | 2 | 3.48
IC FLASH 4MBIT PARALLEL 32DIP | SST39SF040-70-4C-PHE-ND | 3 | 3.99
XTAL OSC XO 8.0000MHZ HCMOS TTL | 535-9184-5-ND | 2 | 3.68
 |  |  | 62.625
 | Shipping | 6.99 | 69.615
 | Tax | 1.075 | 74.836125 | 5.221125
 |  | Total | 74.84
Part assembly
Buck-Boost 5v to 5v Regulator | TPS630701RNMT | 2 | 7.25
Inductor | XFL4020-152MEC | 2 | 2.09
Supervisor Chip | TLV809EA46DBZR | 5 | 0.66
0.1uF 0402 Capacitors | CL05B104KA5NNNC | 20 | 0.04
USB to Parallel Chip | FT240XS-R | 2 | 9.71
3.3V Regulator | LD1117S33TR | 5 | 0.66
 | Boards (105* mm x 95 mm) | 5 | 5.71
 | Parts | 20.41 | 26.12
 | Assembly (on two boards) | 67.21 | 72.92
 | Shipping | 27.77 | 100.69
 | First Time Discount | -10 | 90.69
 | Tax | 1.0825 | 98.171925 | 7.481925
 |  | Total | 98.17
 |  | Project Total | 173.01
