sigroot/MCDProject/KicadFiles/SingleBoardComputer/SingleBoardComputer.kicad_pcb

## KiCad design KicadFiles/SingleBoardComputer/SingleBoardComputer.kicad_pcb (2025-04-24)

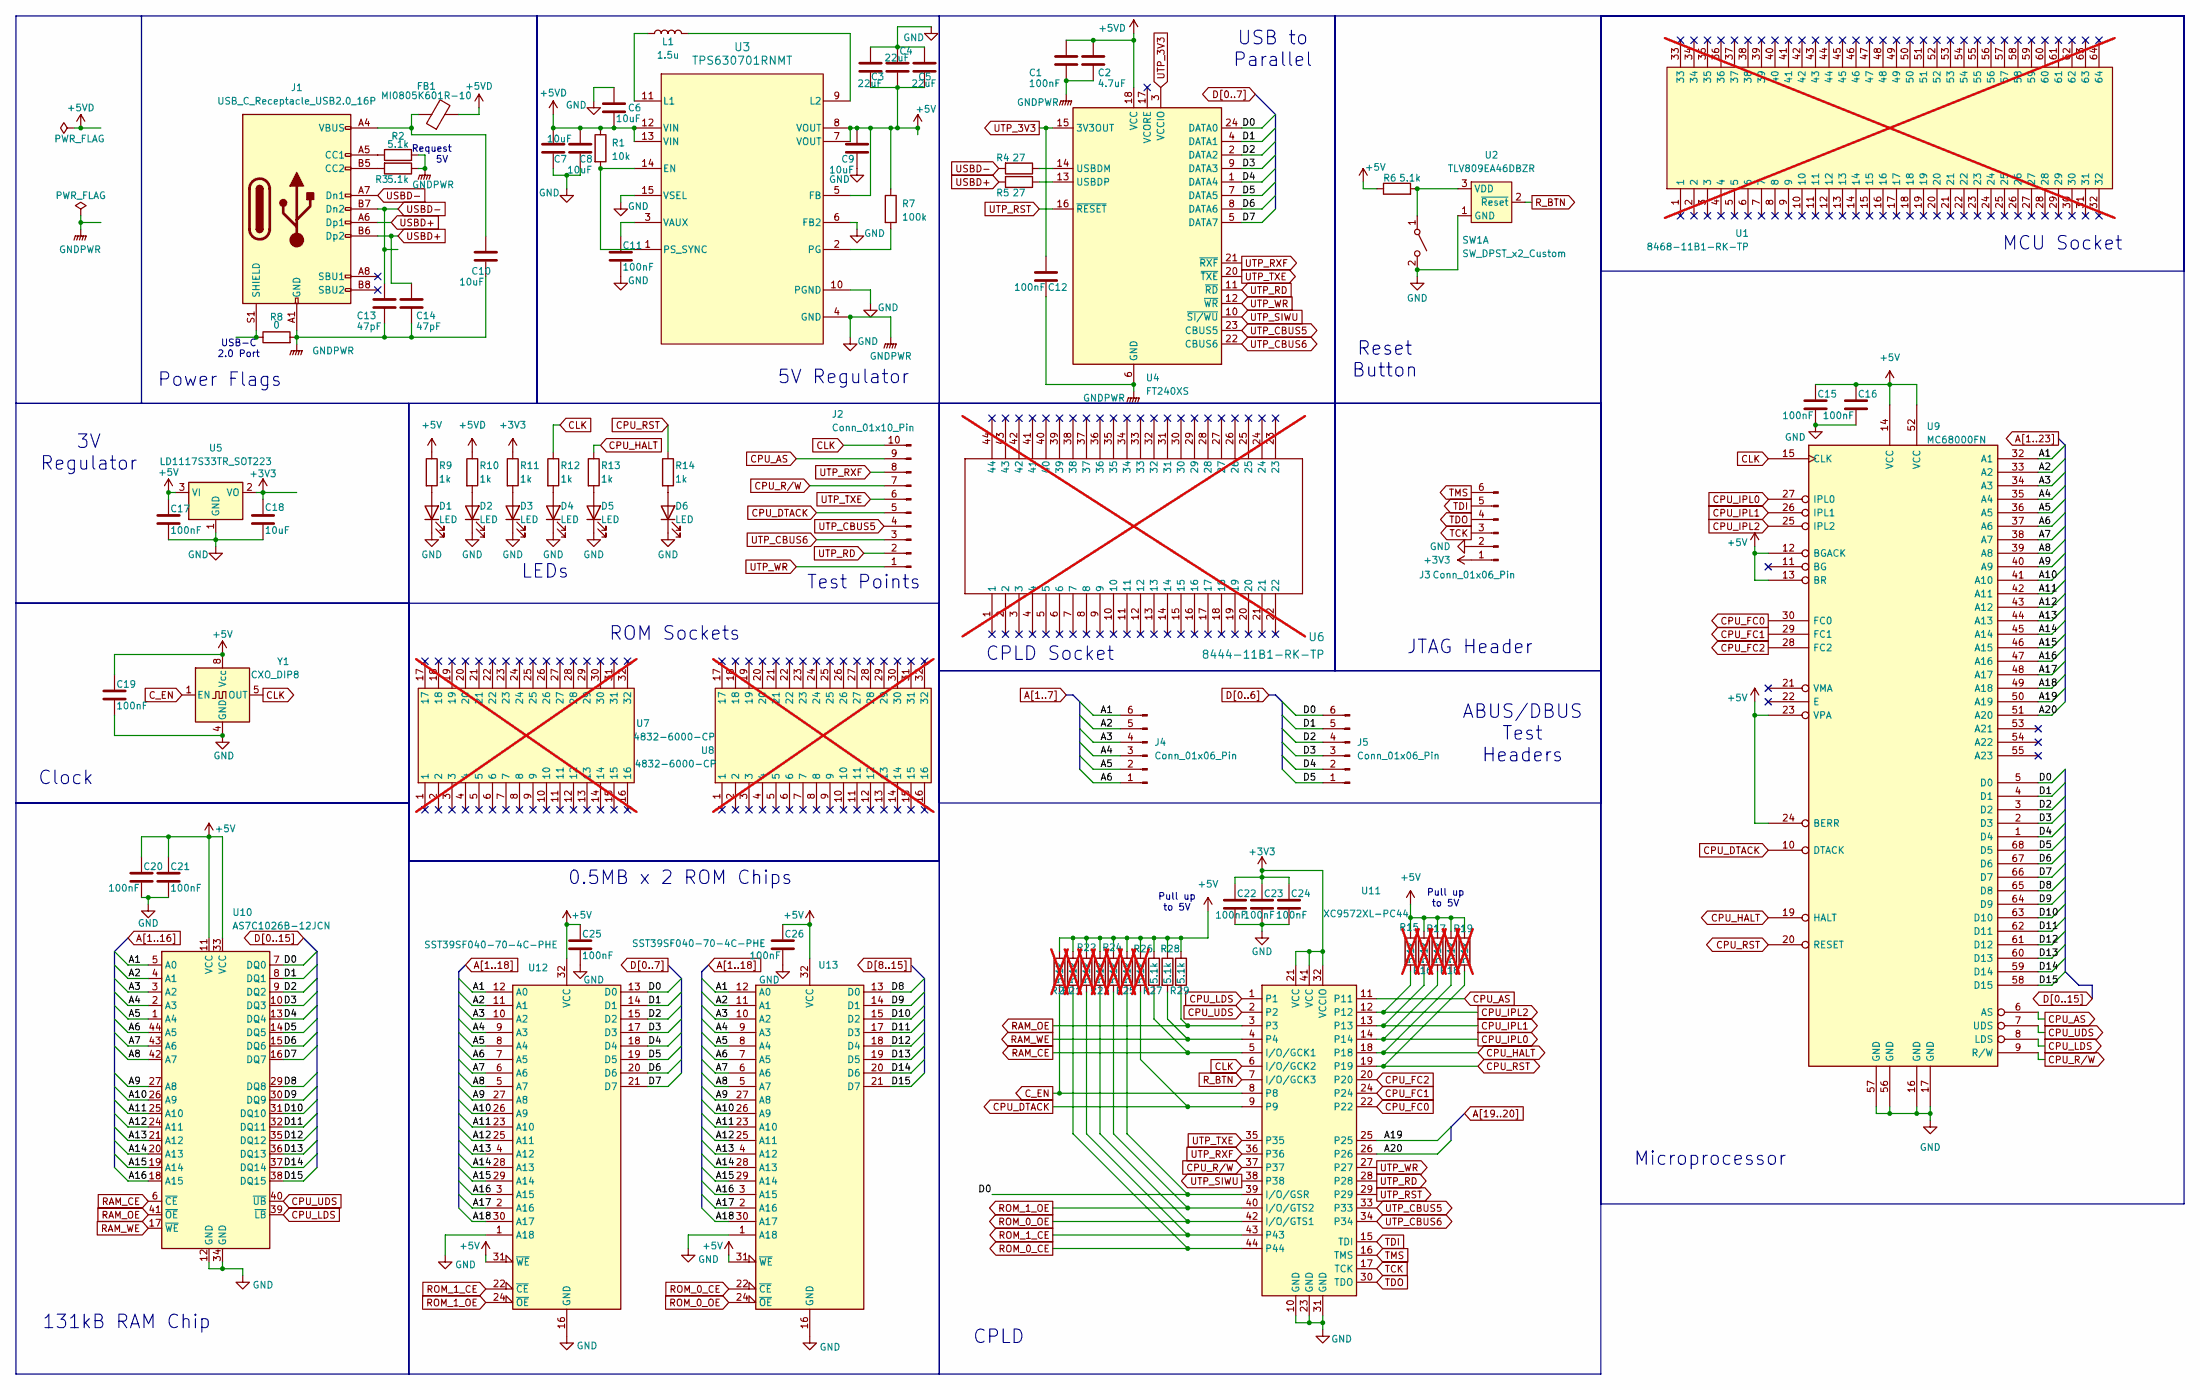
[picture p2: schematic SingleBoardComputer.kicad_sch, Single Board Computer]

Parts:
C1, C12, C15, C16, C17, C19, C20, C21, C22, C23, C24, C25, C26: 100nF; C_0603_1608Metric_Pad1.08x0.95mm_HandSolder
C2: 4.7uF; C_0603_1608Metric_Pad1.08x0.95mm_HandSolder
C3, C4, C5: 22uF; C_0805_2012Metric_Pad1.18x1.45mm_HandSolder
C6, C9: 10uF; C_0603_1608Metric_Pad1.08x0.95mm_HandSolder
C7, C8, C10, C18: 10uF; C_0805_2012Metric_Pad1.18x1.45mm_HandSolder
C11: 100nF; C_0402_1005Metric_Pad0.74x0.62mm_HandSolder; LCSC PN C155422
C13, C14: 47pF; C_0805_2012Metric_Pad1.18x1.45mm_HandSolder
D1, D2, D3, D4, D5, D6: LED; LED_0805_2012Metric_Pad1.15x1.40mm_HandSolder
FB1: MI0805K601R-10; L_0805_2012Metric_Pad1.15x1.40mm_HandSolder
J1: USB_C_Receptacle_USB2.0_16P; CUI_UJ20-C-V-C-3-SMT-TR
J2: Conn_01x10_Pin; PinHeader_1x10_P2.54mm_Vertical
J3, J4, J5: Conn_01x06_Pin; PinHeader_1x06_P2.54mm_Vertical
L1: 1.5u; L_Coilcraft_XxL4020; LCSC PN C3033018
R1: 10k; R_0805_2012Metric_Pad1.20x1.40mm_HandSolder
R2, R3, R6, R27, R28, R29: 5.1k; R_0805_2012Metric_Pad1.20x1.40mm_HandSolder
R4, R5: 27; R_0805_2012Metric_Pad1.20x1.40mm_HandSolder
R7: 100k; R_0805_2012Metric_Pad1.20x1.40mm_HandSolder
R8: 0; R_0805_2012Metric_Pad1.20x1.40mm_HandSolder
R9, R10, R11, R12, R13, R14: 1k; R_0805_2012Metric_Pad1.20x1.40mm_HandSolder
R15, R16, R17, R18, R19, R20, R21, R22, R23, R24, R25, R26: 5.1k; R_0805_2012Metric_Pad1.20x1.40mm_HandSolder; not fitted
SW1: SW_DPST_x2_Custom; SW_SPST_PTS647_Sx38
U1: 8468-11B1-RK-TP; PLCC-68_THT-Socket; not fitted
U2: TLV809EA46DBZR; SOT-23
U3: TPS630701RNMT; RNM0015A; LCSC PN C181473
U4: FT240XS; SSOP-24_3.9x8.7mm_P0.635mm; LCSC PN C69082
U5: LD1117S33TR_SOT223; SOT-223-3_TabPin2; LCSC PN LD1117S33TR
U6: 8444-11B1-RK-TP; TO_11B1-RK-TP_3MM; not fitted
U7, U8: 4832-6000-CP; DIP-32_W15.24mm_Socket; not fitted
U9: MC68000FN; PLCC-68_THT-Socket
U10: AS7C1026B-12JCN; SOJ-44_10.16x28.575mm_P1.27mm
U11: XC9572XL-PC44; PLCC-44_THT-Socket
U12, U13: SST39SF040-70-4C-PHE; DIP-32_W15.24mm_Socket_LongPads
Y1: CXO_DIP8; Oscillator_DIP-8

Connections:
+3V3: C18.1, C22.1, C23.1, C24.1, J3.1, R11.1, U5.2 (VO), U11.21 (VCC), U11.32 (VCCIO), U11.41 (VCC)
+5V: C3.2, C4.2, C5.2, C9.1, C15.1, C16.1, C17.1, C19.1, C20.1, C21.1, C25.1, C26.1, R6.1, R7.1, R9.1, R15.1, R16.1, R17.1, R18.1, R19.1, R20.1, R21.1, R22.1, R23.1, R24.1, R25.1, R26.1, R27.1, R28.1, R29.1, U3.5 (FB), U3.7 (VOUT), U3.8 (VOUT), U5.3 (VI), U9.12 (BGACK), U9.13 (BR), U9.14 (VCC), U9.23 (VPA), U9.24 (BERR), U9.52 (VCC), U10.11 (VCC), U10.33 (VCC), U12.31 (~WE), U12.32 (VCC), U13.31 (~WE), U13.32 (VCC), Y1.8 (Vcc)
+5VD: C1.1, C2.1, C6.2, C7.1, C8.1, FB1.2, R1.1, R10.1, U3.12 (VIN), U3.13 (VIN), U4.18 (VCC)
A1: J4.6, U9.32 (A1), U10.5 (A0), U12.12 (A0), U13.12 (A0)
A2: J4.5, U9.33 (A2), U10.4 (A1), U12.11 (A1), U13.11 (A1)
A3: J4.4, U9.34 (A3), U10.3 (A2), U12.10 (A2), U13.10 (A2)
A4: J4.3, U9.35 (A4), U10.2 (A3), U12.9 (A3), U13.9 (A3)
A5: J4.2, U9.36 (A5), U10.1 (A4), U12.8 (A4), U13.8 (A4)
A6: J4.1, U9.37 (A6), U10.44 (A5), U12.7 (A5), U13.7 (A5)
A7: U9.38 (A7), U10.43 (A6), U12.6 (A6), U13.6 (A6)
A8: U9.39 (A8), U10.42 (A7), U12.5 (A7), U13.5 (A7)
A9: U9.40 (A9), U10.27 (A8), U12.27 (A8), U13.27 (A8)
A10: U9.41 (A10), U10.26 (A9), U12.26 (A9), U13.26 (A9)
A11: U9.42 (A11), U10.25 (A10), U12.23 (A10), U13.23 (A10)
A12: U9.43 (A12), U10.24 (A11), U12.25 (A11), U13.25 (A11)
A13: U9.44 (A13), U10.21 (A12), U12.4 (A12), U13.4 (A12)
A14: U9.45 (A14), U10.20 (A13), U12.28 (A13), U13.28 (A13)
A15: U9.46 (A15), U10.19 (A14), U12.29 (A14), U13.29 (A14)
A16: U9.47 (A16), U10.18 (A15), U12.3 (A15), U13.3 (A15)
A17: U9.48 (A17), U12.2 (A16), U13.2 (A16)
A18: U9.49 (A18), U12.30 (A17), U13.30 (A17)
A19: U9.50 (A19), U11.25
A20: U9.51 (A20), U11.26
CLK: J2.10, R12.1, U9.15 (CLK), U11.6 (I/O/GCK2), Y1.5 (OUT)
CPU_AS: J2.9, U9.6 (AS), U11.11
CPU_DTACK: J2.5, R26.2, U9.10 (DTACK), U11.9
CPU_FC0: U9.30 (FC0), U11.22
CPU_FC1: U9.29 (FC1), U11.24
CPU_FC2: U9.28 (FC2), U11.20
CPU_HALT: R13.1, R18.2, U9.19 (HALT), U11.18
CPU_IPL0: R17.2, U9.27 (IPL0), U11.14
CPU_IPL1: R16.2, U9.26 (IPL1), U11.13
CPU_IPL2: R15.2, U9.25 (IPL2), U11.12
CPU_LDS: U9.8 (LDS), U10.39 (~LB), U11.1
CPU_RST: R14.1, R19.2, U9.20 (RESET), U11.19
CPU_R/W: J2.7, U9.9 (R/W), U11.37
CPU_UDS: U9.7 (UDS), U10.40 (~UB), U11.2
C_EN: R20.2, U11.8, Y1.1 (EN)
D0: J5.6, R25.2, U4.24 (DATA0), U9.5 (D0), U10.7 (DQ0), U11.39 (I/O/GSR), U12.13 (D0)
D1: J5.5, U4.4 (DATA1), U9.4 (D1), U10.8 (DQ1), U12.14 (D1)
D2: J5.4, U4.2 (DATA2), U9.3 (D2), U10.9 (DQ2), U12.15 (D2)
D3: J5.3, U4.9 (DATA3), U9.2 (D3), U10.10 (DQ3), U12.17 (D3)
D4: J5.2, U4.1 (DATA4), U9.1 (D4), U10.13 (DQ4), U12.18 (D4)
D5: J5.1, U4.7 (DATA5), U9.68 (D5), U10.14 (DQ5), U12.19 (D5)
D6: U4.8 (DATA6), U9.67 (D6), U10.15 (DQ6), U12.20 (D6)
D7: U4.5 (DATA7), U9.66 (D7), U10.16 (DQ7), U12.21 (D7)
D8: U9.65 (D8), U10.29 (DQ8), U13.13 (D0)
D9: U9.64 (D9), U10.30 (DQ9), U13.14 (D1)
D10: U9.63 (D10), U10.31 (DQ10), U13.15 (D2)
D11: U9.62 (D11), U10.32 (DQ11), U13.17 (D3)
D12: U9.61 (D12), U10.35 (DQ12), U13.18 (D4)
D13: U9.60 (D13), U10.36 (DQ13), U13.19 (D5)
D14: U9.59 (D14), U10.37 (DQ14), U13.20 (D6)
D15: U9.58 (D15), U10.38 (DQ15), U13.21 (D7)
GND: C1.2, C2.2, C3.1, C4.1, C5.1, C6.1, C7.2, C8.2, C9.2, C10.2, C11.2, C12.2, C13.2, C14.2, C15.2, C16.2, C17.2, C18.2, C19.2, C20.2, C21.2, C22.2, C23.2, C24.2, C25.2, C26.2, D1.1 (K), D2.1 (K), D3.1 (K), D4.1 (K), D5.1 (K), D6.1 (K), J1.A1 (GND), J1.A12 (GND), J1.B1 (GND), J1.B12 (GND), J3.2, R2.2, R3.1, R8.2, SW1.2 (B), U2.1 (GND), U3.4 (GND), U3.6 (FB2), U3.10 (PGND), U3.15 (VSEL), U4.6 (GND), U4.19 (GND), U5.1 (GND), U9.16 (GND), U9.17 (GND), U9.56 (GND), U9.57 (GND), U10.12 (GND), U10.34 (GND), U11.10 (GND), U11.23 (GND), U11.31 (GND), U12.1 (A18), U12.16 (GND), U13.1 (A18), U13.16 (GND), Y1.4 (GND)
unnamed: C10.1, FB1.1, J1.A4 (VBUS), J1.A9 (VBUS), J1.B4 (VBUS), J1.B9 (VBUS)
unnamed: D1.2 (A), R9.2
unnamed: D2.2 (A), R10.2
unnamed: D3.2 (A), R11.2
unnamed: D4.2 (A), R12.2
unnamed: D5.2 (A), R13.2
unnamed: D6.2 (A), R14.2
unnamed: J1.A5 (CC1), R2.1
unnamed: J1.B5 (CC2), R3.2
unnamed: J1.S1 (SHIELD), R8.1
unnamed: R6.2, SW1.1 (A), U2.3 (VDD)
unnamed: R1.2, U3.1 (PS_SYNC), U3.14 (EN)
unnamed: L1.1, U3.11 (L1)
unnamed: L1.2, U3.9 (L2)
unnamed: R7.2, U3.2 (PG)
unnamed: C11.1, U3.3 (VAUX)
unnamed: R4.1, U4.14 (USBDM)
unnamed: R5.1, U4.13 (USBDP)
RAM_CE: R27.2, U10.6 (~CE), U11.5 (I/O/GCK1)
RAM_OE: R29.2, U10.41 (~OE), U11.3
RAM_WE: R28.2, U10.17 (~WE), U11.4
ROM_0_CE: R21.2, U11.44, U13.22 (~CE)
ROM_0_OE: R23.2, U11.42 (I/O/GTS1), U13.24 (~OE)
ROM_1_CE: R22.2, U11.43, U12.22 (~CE)
ROM_1_OE: R24.2, U11.40 (I/O/GTS2), U12.24 (~OE)
R_BTN: U2.2 (~Reset), U11.7 (I/O/GCK3)
TCK: J3.3, U11.17 (TCK)
TDI: J3.5, U11.15 (TDI)
TDO: J3.4, U11.30 (TDO)
TMS: J3.6, U11.16 (TMS)
USBD+: C14.1, J1.A6 (Dp1), J1.B6 (Dp2), R5.2
USBD-: C13.1, J1.A7 (Dn1), J1.B7 (Dn2), R4.2
UTP_3V3: C12.1, U4.3 (VCCIO), U4.15 (3V3OUT)
UTP_CBUS5: J2.4, U4.23 (CBUS5), U11.33
UTP_CBUS6: J2.3, U4.22 (CBUS6), U11.34
UTP_RD: J2.2, U4.11 (~RD), U11.28
UTP_RST: U4.16 (~RESET), U11.29
UTP_RXF: J2.8, U4.21 (~RXF), U11.36
UTP_SIWU: U4.10 (~SI/WU), U11.38
UTP_TXE: J2.6, U4.20 (~TXE), U11.35
UTP_WR: J2.1, U4.12 (~WR), U11.27

Notes on the sheet:
Power Flags
USB to Parallel
USB-C 2.0 Port
Test Points
Request 5V
5V Regulator
Reset Button
ABUS/DBUS Test Headers
0.5MB x 2 ROM Chips
CPLD Socket
131kB RAM Chip
CPLD
Clock
Pull up to 5V
ROM Sockets
3V Regulator
Microprocessor
MCU Socket
LEDs
JTAG Header

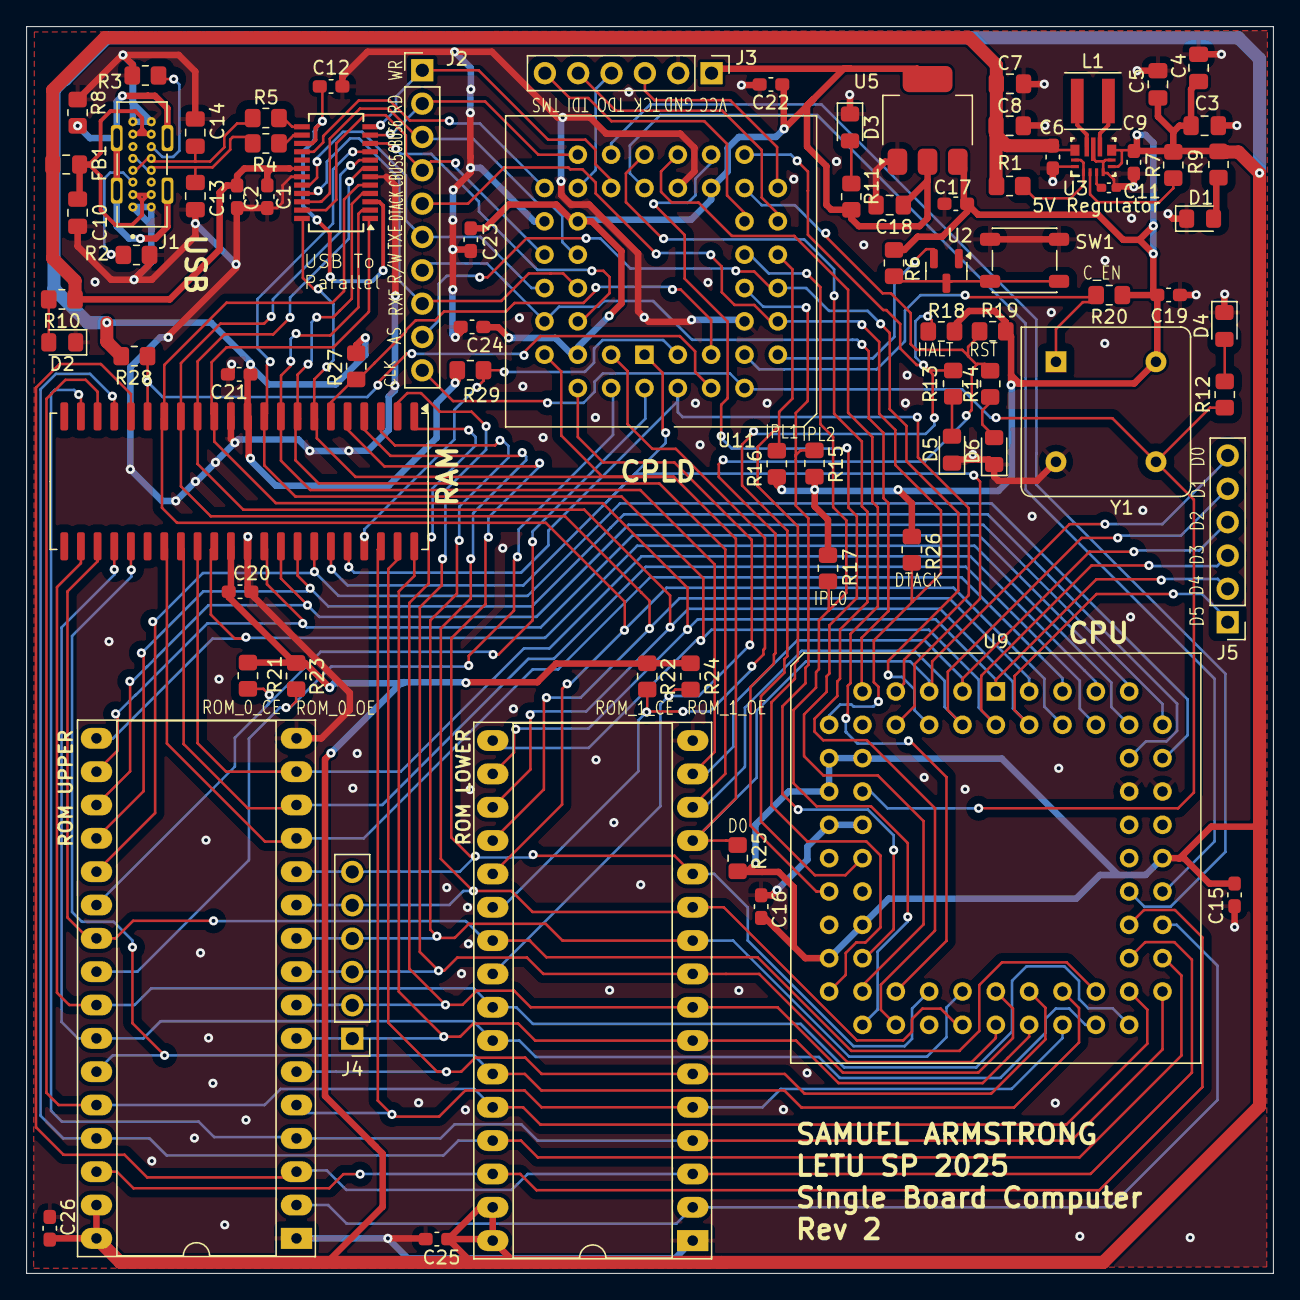
[picture p3: board SingleBoardComputer.kicad_pcb from above]

Board: 2 copper layers, 95.0 x 95.0 mm, 79 parts (0 on the bottom side), 96 nets.
