sigroot/MCDProject/(commit log)

2025-01-23 Week 1 Done
    [Metadata.ods, SingleBoardComputer.kicad_pcb, SingleBoardComputer.kicad_sch]
2025-01-26 Schematic v1.0 done
    [Metadata.ods, SingleBoardComputer.kicad_sch]
2025-01-29 Schematic V2.0
    [Metadata.ods, SingleBoardComputer.kicad_sch]
2025-02-03 Changed 5V regulator to TPS63070 (which JLCPCB can provide and solder)
    [Metadata.ods, SingleBoardComputer.kicad_sch]
2025-02-05 Updated some schematic, added sockets to BOM, building PCB
    [Metadata.ods, SingleBoardComputer.kicad_pcb, SingleBoardComputer.kicad_sch]
2025-02-10 PCB before schematic modification
    [Metadata.ods, SingleBoardComputer.kicad_pcb, SingleBoardComputer.kicad_sch]
2025-02-12 Schematic after corrections
    [Metadata.ods, SingleBoardComputer.kicad_pcb, SingleBoardComputer.kicad_sch]
2025-02-13 Correction Corrections
    [SingleBoardComputer.kicad_pcb, SingleBoardComputer.kicad_sch]
2025-02-15 PCB done
    [Metadata.ods, SingleBoardComputer.kicad_pcb, SingleBoardComputer.kicad_sch]
2025-02-18 Purchase 1
    [Metadata.ods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]
2025-03-16 Backup after working board
    [Metadata.ods, SingleBoardComputer.kicad_sch]
2025-03-24 Cleaning Directories
    [Metadata.ods]
2025-04-10 Working Main Menu
    [Metadata.ods]
2025-04-14 Monitor done?
    [Metadata.ods]
2025-04-20 included VHDL
    [Metadata.ods, main_pad.csv]
2025-04-24 Completed Demonstration
    [Metadata.ods, SingleBoardComputer.kicad_pcb]
